clowrey/esp32-wheel-balancer/hardware/display_case/structure-drawing.png

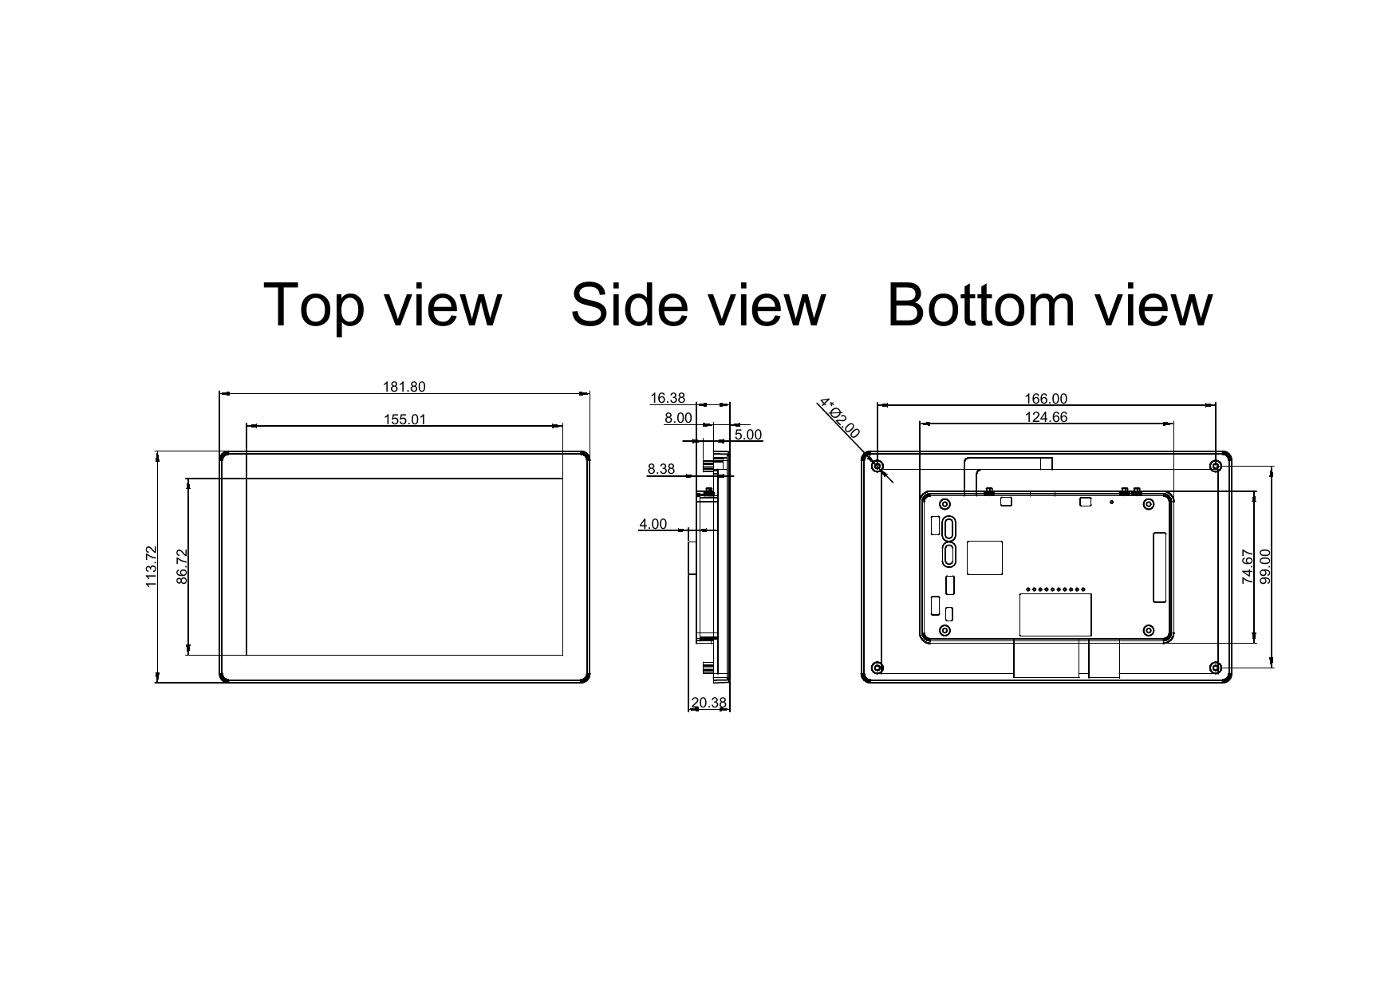
hardware/display_case/structure-drawing.png
