clowrey/esp32-wheel-balancer/hardware/display_case/display_case_assembly.step

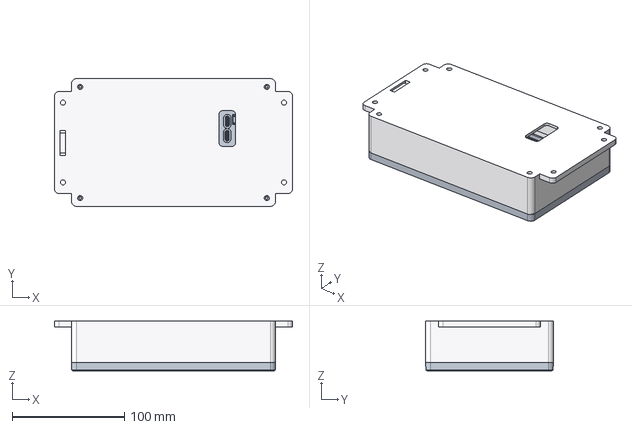
[picture p6: CAD file, 2026-11-12]
hardware/display_case/display_case_assembly.step
211.8 x 113.7 x 44.2 mm
display_case
