clowrey/esp32-wheel-balancer/hardware/display_case/display_case.step

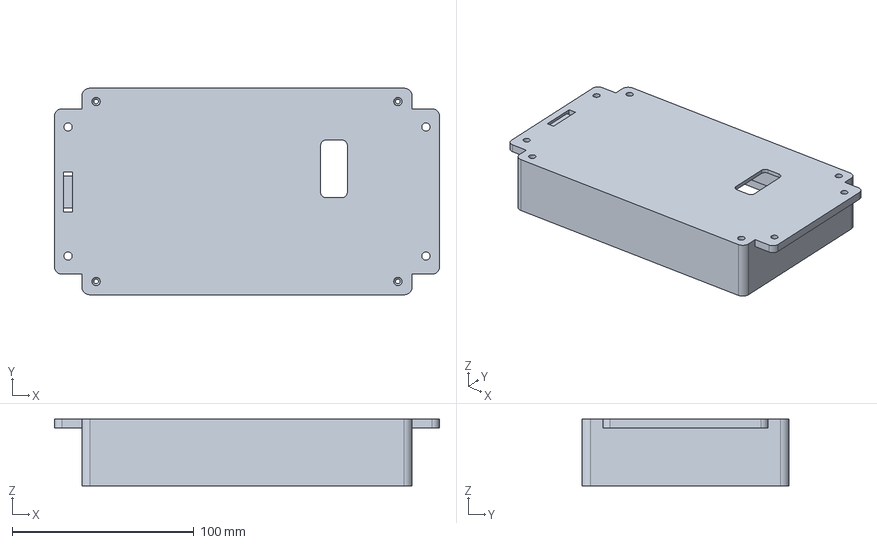
[picture p7: CAD file, 2026-11-12]
hardware/display_case/display_case.step
211.8 x 113.7 x 36.8 mm
