clowrey/esp32-wheel-balancer/hardware/display_case/jc1060p470c_display.step

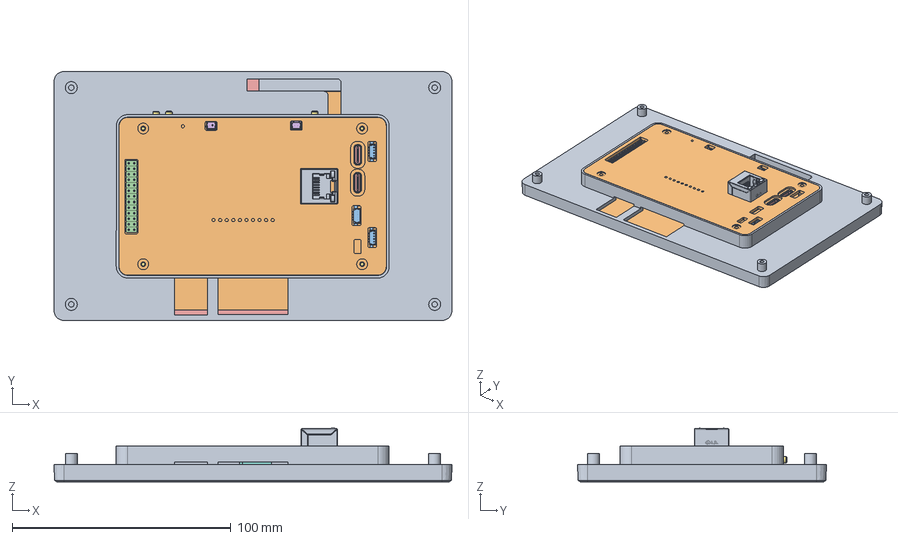
[picture p8: CAD file, 2026-11-12]
hardware/display_case/jc1060p470c_display.step
181.8 x 113.7 x 24.5 mm
