clowrey/esp32-wheel-balancer/components/balancer/ui_model.h

#pragma once
// What the touchscreen UI needs from the rest of the firmware. The ESPHome
// component implements this on the device; on a PC (tools/ui_sim, the host
// tests) ModelCore with the simulated wheel does.

#include <string>
#include <vector>

#include "dsp_job.h"
#include "dsp_measurement.h"
#include "dsp_types.h"

namespace bal {

struct LiveData {
  double rpm = 0;              // 0 when no tach for a while
  bool tach_ok = false;
  int revs = 0;                // revolutions in the live average
  cplx v[kChannels];           // 1x, configured quantity, lag-complex
  double order_amp[kChannels][kMaxOrder] = {};
  float wave[kChannels][kWaveBins] = {};  // g
  float rms_g[kChannels] = {0, 0};
  float peak_frac[kChannels] = {0, 0};   // of the sensor's full-scale range
  float fs = 0;                // measured reading rate
  bool acq_ok = false;         // acquisition running
  bool aligned = false;        // timebase locked
  unsigned resyncs = 0, overflows = 0, glitches = 0, tach_pulses = 0;
  // Every axis of each sensor over the last second (g): mean, mostly gravity,
  // and AC rms, the shaking. For the axis picker on the settings screen.
  float axis_mean[kChannels][3] = {};
  float axis_rms[kChannels][3] = {};
  unsigned read_errors[kChannels] = {0, 0};  // failed I2C reads, per sensor
  unsigned missed[kChannels] = {0, 0};       // readings skipped because the task fell behind
  // The latest raw readings of each sensor's measured axis (g, oldest first),
  // for the LIVE screen's raw trace. raw_n is 0 when there are none (demo).
  static constexpr int kRawPts = 500;
  float raw[kChannels][kRawPts] = {};
  int raw_n[kChannels] = {0, 0};
};

struct UiSettings {
  bool invert[kChannels] = {false, false};
  int axis[kChannels] = {2, 2};  // sensor axis measured: 0 X, 1 Y, 2 Z (starts from the YAML)
  Quantity quantity = Quantity::VELOCITY_MM_S;
  bool mass_oz = false;  // show and enter balance weights in ounces instead of grams
  double window = 0.03;
  int target_revs = 30;
  double max_phase_unc_deg = 2.0;
};

class UiModel {
 public:
  virtual ~UiModel() = default;

  virtual BalanceJob &job() = 0;
  virtual UiSettings &settings() = 0;
  virtual void apply_settings(bool persist) = 0;
  virtual void save_job_defaults() = 0;

  virtual const LiveData &live() = 0;

  // One measurement run for the job's current step.
  virtual void start_run() = 0;
  virtual void cancel_run() = 0;
  virtual bool accept_run(std::string *error) = 0;
  virtual bool measuring() const = 0;
  virtual const MeasureStats &run_stats() = 0;
  virtual RevStatus last_rev_status() const = 0;
  virtual const std::vector<cplx> &run_dots(int channel) = 0;  // recent accepted revolutions
  // Lock the test speed (job + current run). rpm <= 0 means "current speed".
  virtual void lock_speed(double rpm) = 0;
  // The speed locks by itself when steady inside this range (0, 0: manual only).
  virtual double auto_lock_lo() const { return 0; }
  virtual double auto_lock_hi() const { return 0; }

  // Saved machine (influence model) for single-run trim balancing.
  virtual bool has_machine() const = 0;
  virtual void save_machine() = 0;
  virtual bool start_trim() = 0;
  virtual std::string machine_summary() const = 0;

  // One line per item: Wi-Fi, IP address, Home Assistant. Empty off-device.
  virtual std::string network_status() const { return ""; }

  // Raw stream of every reading to the USB log, for a PC (tools/mpu_log.py).
  virtual bool pc_log() const { return false; }
  virtual void set_pc_log(bool /*on*/) {}

  // Teach input of the tach sensor (LX-101 pink wire, through a transistor).
  // While on, the sensor sees its teach key held down. has_tach_teach() is
  // false when no teach_pin is set in the YAML.
  virtual bool has_tach_teach() const { return false; }
  virtual void set_tach_teach(bool /*on*/) {}
  virtual bool tach_teach() const { return false; }

  // Demo mode with the simulated wheel.
  virtual bool simulate() const = 0;
  virtual void sim_spin() = 0;
};

}  // namespace bal
