clowrey/esp32-wheel-balancer/(commit log)

2026-10-09 Project plan, board config, pinout and front-end notes
    Two-plane dynamic balancer on the Guition JC1060P470C (ESP32-P4).
    Board YAML from CellKeeper-BMS-LCD; JP1 pin map from the schematic.
    Claude-Session: https://claude.ai/code/session_01YLkpa8974GbSVrsA63K8x1
    [hardware_guition_jc1060p470.yaml]
2026-10-09 Record v1 decisions: 1 hp motor rotor, 100 mV/g IEPE, GPIO tach, air drive
    - PLAN §0 decisions table; §5.1 speed-window and coast-down capture for the
    air-spun rotor; §6.1 1 hp rotor defaults (G2.5, ISO limit, trial-weight
    helper); add/remove (drill) correction mode
    - Front end: gain x10 for 100 mV/g sensors; tach is a 3.3 V GPIO pulse
    - Open questions narrowed to stand type, rotor details, tach pulse shape
    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
2026-10-09 Phase 2: DSP core, balancing solver, host tests and simulator
    - dsp_revolution: per-revolution direct DFT of orders 1-10 against the
    tach angle (no resampling), 128-bin waveform, glitch/gap handling, fixed
    ADC delay removal
    - dsp_measurement: speed-window accumulator for coast-down capture, block
    standard error, phase uncertainty, phase-vs-speed slope, ready logic
    - dsp_balance: influence matrix, least-squares correction with condition
    number, trial check, add/remove mode, split to fixed positions, drill
    depth, ISO 21940-11 limit, trial-weight helper
    - tests: doctest host suite incl. simulated air-driven two-plane balance
    (worst of 20 seeds: 1.33% / 0.69 deg vs the 2% / 1 deg exi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
    [balance_cli.cpp, crosscheck_pyprb.py, dsp_balance.cpp, dsp_balance.h, dsp_measurement.cpp, dsp_measurement.h, dsp_revolution.cpp, dsp_revolution.h]
2026-10-09 CI: host tests, pyPRB cross-check and ESP32-P4 firmware build
    GitHub Actions compiles the firmware because the dev workspace can't reach
    Espressif's download and component hosts.
    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
2026-10-09 Phase 1 acquisition, job logic, timebase and demo simulator
    - acq_capture: PCM1808 on I2S1 (master, 32-bit slots), MCPWM capture of
    tach, every 256th LRCK edge and a DMA-complete soft catch on one 80 MHz
    timer; acquisition task on core 1 with gap/overflow detection
    - dsp_timebase: tach ticks -> fractional frame index, tested across timer
    wrap, crystal error and lost captures
    - dsp_job: wizard state and arithmetic (runs, keep-trial, split, drill,
    ISO per plane, verify residual and trim), user angle convention
    - dsp_sim: revolution-level rotor for the on-device demo mode
    - measurement: settled when the vector is known to within a floor, so a
    well balanced verify run completes
    Co-Aut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
    [dsp_job.cpp, dsp_job.h, dsp_measurement.cpp, dsp_measurement.h, dsp_sim.cpp, dsp_sim.h, test_dsp.cpp]
2026-10-09 Phase 3: touchscreen UI, ESPHome component, demo firmware, UI preview
    - ui: six LVGL 9 screens (home, rotor setup, measure, correction/verify,
    live vibration, settings) with rotor dials, polar plots, numeric keypad
    - ui_core: shared model (runs, live averages, polar dots, demo rotor,
    saved machine / trim) used by both the firmware and the PC preview
    - balancer component: YAML schema, acquisition start, NVS persistence of
    settings/job/machine, HA sensors (rpm, 1x amplitude/phase A/B)
    - balancer-jc1060p470.yaml (sensors) and balancer-demo.yaml (simulated
    rotor, no front end needed)
    - tools/ui_preview: renders every screen on a PC against LVGL 9.5
    - CI: UI screenshots artifact, compile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
    [balance_cli.cpp, balancer.cpp, balancer.h, dsp_balance.cpp, dsp_balance.h, dsp_job.cpp, dsp_job.h, dsp_measurement.cpp]
2026-10-09 Fix P4 compile errors: task handle name clash, status_set_error API; docs and UI screenshots
    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
    [balancer.cpp]
2026-11-12 Tire balancer: MPU-6050 sensors, tire preset and demo wheel
    Adds a second sensor path for slow rotors on a soft rig (car wheels spun by
    hand), selected in YAML with `sensor_type: mpu6050`. The PCM1808 path and
    its firmware are unchanged.
    - acq_mpu: one or two MPU-6050-family boards on their own I2C bus. Each
    data-ready edge and the tach are latched by one MCPWM capture timer; the
    task reads the sensor after each edge and discards readings it cannot
    attribute to an edge.
    - dsp_resample: interpolates each sensor (own oscillator, own rate) onto a
    uniform grid defined by the capture timer, so tach edges land on it by
    division and the existing per-revolution analysis is reused as is.
    -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
    [acq_mpu.cpp, acq_mpu.h, balancer.cpp, balancer.h, dsp_balance.cpp]
2026-11-12 Tire rig docs: wiring on the 26-pin header, LX-101 tach, plan and README
    - docs/hardware/tire-rig.md: hookup by JP1 pin / ribbon wire, GY-521 notes,
    sensor mounting, leaf-spring tuning and tap test, procedure, what the
    preset sets, how the timing works.
    - Tach is a Panasonic LX-101 mark sensor: NPN open collector on GPIO32 with
    a 4.7k pull-up to 3V3, its own 12-24 V supply, falling edge.
    - PLAN §3.3 and Phase 4b, README, CLAUDE.md and pinout updated; screenshots
    refreshed and the tire set added under docs/ui/tire.
    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
2026-11-12 MPU-6050 path: fixes from an independent code review
    - Take each sensor's filter delay off its own timestamps (two boards with
    different chips no longer share sensor A's delay).
    - Resampler: bridge at most 6 lost readings (was 50), and restart the grid
    when the capture timer has wrapped unseen during a long silence.
    - Clock the I2C bus free before probing (a reboot can cut a transfer
    short), and set a sensor up again if it stops reporting.
    - Reject YAML where the bus is too slow for the reading rate.
    - A saved two-plane machine is not offered for trim with one sensor.
    - RevolutionAnalyzer frees the default-size ring when configured smaller.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
    [acq_mpu.cpp, acq_mpu.h, dsp_resample.cpp, dsp_revolution.cpp, test_mpu.cpp, ui_core.cpp, ui_core.h]
2026-11-12 Demo mode: move the per-tick revolution buffer off the loop stack
    ModelCore::tick() kept RevResult buf[32] on the stack. Each RevResult is
    about 1.4 KB, so that is ~45 KB on ESPHome's 8 KB loop task. On the board the
    simulate build overflowed the stack on the first loop, core 1 faulted in the
    panic vector, and the watchdog reset it in a boot loop. The buffer is now a
    heap vector in ModelCore.
    [ui_core.cpp, ui_core.h]
2026-11-12 Let large allocations use PSRAM so the sensor firmware can boot
    With PSRAM in caps-only mode, new/malloc only reach internal RAM. The
    revolution analyser's sample rings are std::vectors of up to a few hundred KB,
    so MpuAcquisition's constructor threw bad_alloc in setup() and the tire
    firmware aborted in a boot loop. Switch to CONFIG_SPIRAM_USE_MALLOC: requests
    over 16 KB go to PSRAM, smaller ones stay internal.
2026-11-12 Component: accelerometer (MPU-6050) path only
    Remove the PCM1808/I2S acquisition (acq_capture) and its LRCK timebase
    (dsp_timebase), the sensor_type and preset options, and the motor-rotor
    preset. ModelCore now starts with the tire values; the UI drops the
    sensitivity/gain settings and the air-drive wording. Sensor polarity can
    be set per sensor in YAML (invert). Saved state magic is bumped because
    UiSettings lost its sensitivity and gain fields.
    UI screenshots in docs/ui are now the tire screens.
    Claude-Session: https://claude.ai/code/session_015z7NxjCnXEqyZMQPCpE6dE
    [acq_mpu.h, balancer.cpp, balancer.h, dsp_job.cpp, dsp_job.h, dsp_revolution.h, test_dsp.cpp, test_mpu.cpp]
2026-11-12 Keep only the accelerometer firmware: configs, CI and docs
    Delete the IEPE/PCM1808 build (balancer-jc1060p470.yaml), the motor-rotor
    demo (balancer-demo.yaml), the board-only bring-up config, the front-end
    doc and the legacy BMI160 sketch. CI builds and publishes only
    balancer-tire and balancer-tire-demo. README, PLAN, CLAUDE.md, pinout and
    tire-rig docs now describe the tire balancer alone.
    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
2026-11-12 Sensor debugging: raw trace on LIVE, raw stream to a PC, auto-retry
    - LIVE screen: a 'Raw readings' button swaps the orders panel for the last
    2 s of both sensors' measured axis (mean removed, shared scale, gravity
    per sensor). A 'PC log' button switches the raw stream on and off.
    - Raw stream: every reading of both sensors (x, y, z in counts, capture-timer
    timestamps) goes to the USB log as 'MPU A <t0_us> <n> dt,x,y,z ...' lines
    tagged mpu.raw, six readings per line. pc_log: true in the YAML turns it on
    at boot. tools/mpu_log.py records it to CSV and prints rate, mean, noise,
    |g| and gaps per sensor. The logger's task buffer is raised to 8 KB.
    - A sensor that does not answer at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
    [acq_mpu.cpp, acq_mpu.h, balancer.cpp, balancer.h, mpu_log.py, ui.cpp, ui.h]
2026-11-12 Tire rig: measure the Z axis, through the sensor board
    Mounting the GY-521 flat against a vertical face of the bearing housing is
    easier than standing it on edge, so both sensors now read Z (underside to
    component side). Docs updated to match.
2026-11-12 Tach: press-and-hold TEACH TACH button for the LX-101 teach input
    Optional tach.teach_pin drives the sensor's teach input (pink wire) through
    an NPN transistor: high while the Settings button is held, released after
    20 s at most. Docs and pinout show the wiring on JP1 pin 17 (GPIO20).
    Claude-Session: https://claude.ai/code/session_015z7Nxk9qgsqQqeXKWWERo1
2026-11-12 Add build123d rear case for the 7in display
    Screws onto the four corner standoffs, outline matches the glass, 1 in.
    clear behind the back cover, USB-C window and a cable slot by JP1.
    Dimensions come from Guition's JC1060P470C_I_W_Y structure drawing
    (included); README lists the source of each and what to caliper first.
    Claude-Session: https://claude.ai/code/session_015z7NxgrAUqAEn3yMJYwzx7
    [display_case.step, display_case.stl]
2026-11-12 Display case: measured depths, M2 screws, side mounting tabs
    Chester measured the unit: 7 mm bezel (glass front to its back face) and
    standoffs 5 mm proud of it, M2 thread. Lip now stops short of the bezel.
    Adds 5 mm thick tabs 15 mm out on the left and right, flush with the
    back. STL is now opt-in (--stl); the STEP is the deliverable.
    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
    [display_case.step, display_case.stl]
2026-11-12 Display case: tabs 80% of case height with two holes each
    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
    [display_case.step]
2026-11-12 display_case: fit to the vendor 3D model converted from the DWG
    Bump-out is 3.37 mm above the standoffs (not 8.38), RJ45 8.31 mm, USB-C and
    JP1 positions from the model. Case is now 35.4 mm deep with 1 in. clearance;
    fit check against all parts of the full model finds no contact. Adds the
    converted display STEP (outside parts, case coordinates) and uses it in the
    preview.
    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
    [display_case.step, jc1060p470c_display.step]
2026-11-12 display_case: add assembly STEP with the display fitted in the case
    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
    [display_case_assembly.step]
2026-11-12 display_case: close the gap between the front lip and the bezel
    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
    [display_case.step, display_case_assembly.step]
2026-11-12 display_case: zip-tie anchors at the side cable slot
    Two tie slots through the tab beside the slot exit (with a groove on the
    back face) and a tie bridge on the inside of the back wall.
    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
    [display_case.step, display_case_assembly.step]
2026-11-12 Use the public repo name esp32-wheel-balancer
    Claude-Session: https://claude.ai/code/session_015z7NxihvwQLJ1uyA9Ptev7
2026-11-12 Never reboot for lack of Wi-Fi or Home Assistant
    reboot_timeout: 0s for wifi and api, and power_save_mode: none, as on the
    CellKeeper HMIs. The defaults restart the board after 15 minutes without a
    network, which would lose a run in progress.
2026-11-12 MPU reads: 50 ms I2C timeout instead of 5 ms
    With a flaky sensor connection, ESP-IDF's i2c_master gave up on a read after
    5 ms and a late receive interrupt then wrote through a stale pointer: a store
    access fault in i2c_isr_receive_handler that rebooted the board every couple
    of minutes. A 6-byte read takes about 0.2 ms, so 50 ms only matters when the
    bus is in trouble. No crash in 4 minutes under the same errors after this.
    [acq_mpu.cpp]
2026-11-12 Sensor B on its own I2C bus; per-sensor failure counts and back-off
    - sensor_b can take its own sda_pin/scl_pin. It runs on the P4's LP I2C
    controller (the HP ones carry the touch bus and sensor A), which only
    reaches GPIO0..15. A sensor that hangs no longer stalls the other.
    - New pins: sensor B SDA/SCL on GPIO3/4 (JP1 11/13), INT A on GPIO47
    (pin 10), INT B on GPIO46 (pin 12). Sensor A stays on GPIO1/2.
    - Failed reads are counted per sensor and logged as A/B. A sensor that fails
    5 reads in a row is only tried every 200 ms until it answers.
    - Pinout, tire-rig wiring and PLAN signal chain updated.
    [acq_mpu.cpp, acq_mpu.h, balancer.cpp, balancer.h]
2026-11-12 README: hardware section, two-bus JP1 wiring image and parts list
    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
2026-11-12 LIVE screen: failed and missed readings per sensor
    Each sensor's block shows 'failed reads N, missed M' for that sensor, so a
    bad board or bus is obvious on the screen. The diagnostics box now says
    'tach glitches' (it always counted tach glitches) and labels the combined
    count 'missed + failed'.
    [acq_mpu.cpp, acq_mpu.h, balancer.cpp, ui.cpp, ui_model.h]
2026-11-12 display_case: 2.5 mm M2 holes, tapered counterbores, 0.6 mm longer lip
    Fit feedback from the first print: the M2 holes were tight, the flat end
    of each counterbore printed as an unsupported ceiling, and there was a
    0.6 mm gap between the case and the screen.
    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
    [display_case.step, display_case_assembly.step]
2026-11-13 Settings: pick or auto-detect each sensor's axis; network status
    - Each sensor's measured axis (X/Y/Z) can be changed on the Settings
    screen, starts from the YAML and is saved with SAVE (saved-state version
    bumped, so older saved settings are reset once).
    - Live per-axis gravity (1 s mean) and shake (AC rms) for both sensors, so
    the vertical axis and the responding one are visible.
    - DETECT: rock the sensor's mount the way it should measure for 3 s; the
    axis with clearly the most AC motion (1.5x the next) is chosen, otherwise
    it says so and leaves the choice by hand.
    - Network panel: Wi-Fi SSID and signal, IP address, Home Assistant
    connected or not.
    [acq_mpu.cpp, acq_mpu.h, balancer.cpp, balancer.h, ui.cpp, ui.h, ui_core.cpp, ui_model.h]
2026-11-13 Settings: guided axis finder with a picture of which way to push
    FIND AXES opens a guided screen: a top view of tyre, axle and knuckle with
    an arrow per sensor (A forward/back, the way the car drives; B in/out along
    the axle), live X/Y/Z shake bars for that sensor, START, a 4 s capture and
    the result. A clear winner (1.5x the next axis) is applied; otherwise it
    says why and lets the person retry or pick by hand. Replaces the two DETECT
    buttons.
    [ui.cpp, ui.h]
2026-11-13 Balance weights in grams or ounces, with a 1 oz + 1/4 oz breakdown
    - Settings: 'Weight units' g / oz (saved). New YAML option weight_unit
    (default g); balancer-tire.yaml uses oz for stick-on wheel weights.
    - In oz, every weight shows in oz: trial mass (also typed in oz), suggested
    trial, results, split weights and the ISO limit. Results and the
    suggested trial add the nearest stack of 1 oz and 1/4 oz weights,
    e.g. 'stick on: 1 oz + 1 x 1/4 oz (1.25 oz)'.
    - Computation stays in grams. Saved-state version 4 (settings reset once).
    [balancer.h, ui.cpp, ui.h, ui_core.cpp, ui_model.h]
2026-11-13 Settings save themselves on every change
    Axis buttons, the axis finder, weight units and every Settings row now
    write to flash as soon as they change, so calibrated settings survive a
    reboot or firmware update without tapping SAVE (still there). CLAUDE.md
    and balancer.h note that SavedState's layout must not change without a
    migration, since a size change resets saved settings.
    [balancer.h, ui.cpp]
2026-11-13 Speed locks by itself when held steady; instructions in oz
    - Run 0 has no test speed yet. Once 6 continuous revolutions sit within
    +/-3% of each other and inside 150-450 rpm (wheel defaults), the speed is
    locked at their mean, as if LOCK SPEED had been tapped: hands stay on the
    drill. A gap in the tach starts over. A toast says where it locked.
    - Status and instructions say to hold the speed (drill) or coast through;
    'Above window: slow down', 'Below window: speed up'.
    - Job instructions show the trial mass in oz when oz is selected.
    - Host test for the auto lock; the existing tire test keeps its manual
    LOCK SPEED by turning auto lock off.
2026-11-13 Raw recorder: the last minutes of readings in PSRAM, downloadable
    - Every raw reading of both sensors (x, y, z counts, the axis in use) and
    every tach pulse go into a PSRAM ring with capture-timer timestamps:
    record_minutes (default 10, about 3.7 MB at 250 Hz).
    - GET http://<board>/recording.bin serves it, oldest first, in chunks
    straight from PSRAM (64-byte header + 12-byte records).
    - tools/mpu_recording.py downloads it, prints per-sensor rate, gravity and
    noise and the tach speed range, and writes a CSV for offline analysis.
    [acq_mpu.cpp, acq_mpu.h, balancer.cpp, balancer.h, mpu_recording.py]
2026-11-13 Screen drawn in plain C++ without LVGL; boot crash and freeze fixes
    The touchscreen UI no longer uses LVGL. The screens draw into an RGB565
    frame in PSRAM and only the 16-row bands that changed are sent to the
    panel, the way the CellKeeper HMI does on the same board (its canvas is
    reused here). LVGL's draw buffer took 307 KB of internal RAM, which left
    the Wi-Fi co-processor link almost nothing; the firmware is also 0.4 MB
    smaller. All six screens, the number pad and the axis finder keep their
    layout and behaviour. Text is Roboto (OFL), generated by
    tools/gen_ui_fonts.py.
    tools/ui_sim replaces the LVGL preview: it taps through a whole job with
    the demo wheel and renders every screen (docs/u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
    [balancer.cpp, balancer.h, dsp_types.h, gen_ui_fonts.py, test_ui.cpp]
